Eryk-Mozdzen/rysiek/docs/Prezentacja_BITEHack.pdf

# Rysiek - autonomiczny robot promujący zdrowe żywienie

# ”KoNaR Bravo”

15.12.2024

KoNaR Bravo | RYSIEK | 15.12.2024 | 1 / 11

# Plan prezentacji

### 1 Skąd pomysł?

### 2 Dlaczego ryś?

### 3 Robotyczny bohater

### 4 Proste czyny, niebanalne osiągnięcia

5 Rozszerzenia.

### 6 Podsumowanie działań

KoNaR Bravo | RYSIEK | 15.12.2024 | 2 / 11

# Pomysł

1 Robot motywujący do zdrowego odżywiania.
2 Zastosowanie w miejscach, w których nie myślimy o tym, takich jak codzienny czas w domu, czy w pracy.
3 Przeznaczony do zastosowania indywidualnego.

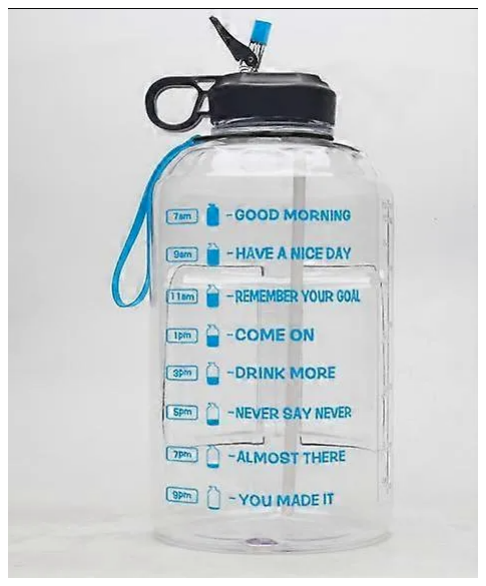
[picture p12: figure]

KoNaR Bravo | RYSIEK | 15.12.2024 | 3 / 11

# Ryś?

### Ryś - dawniej zwany ostrowidzem

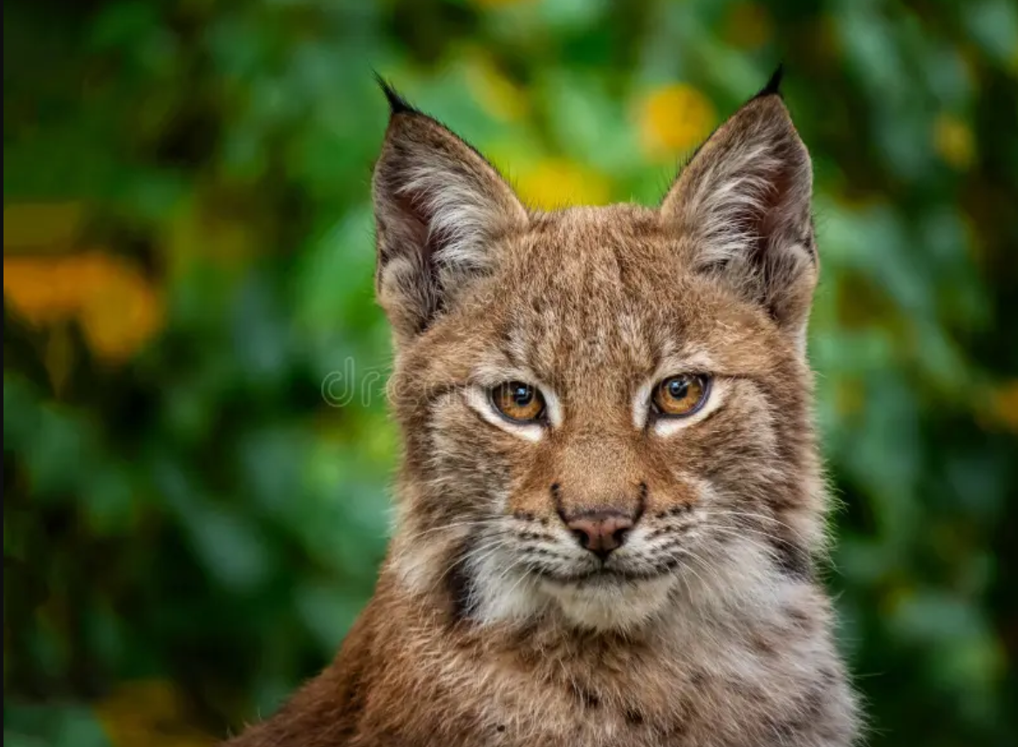
[picture p13: figure]

KoNaR Bravo | RYSIEK | 15.12.2024 | 4 / 11

# Dolina niesamowitości

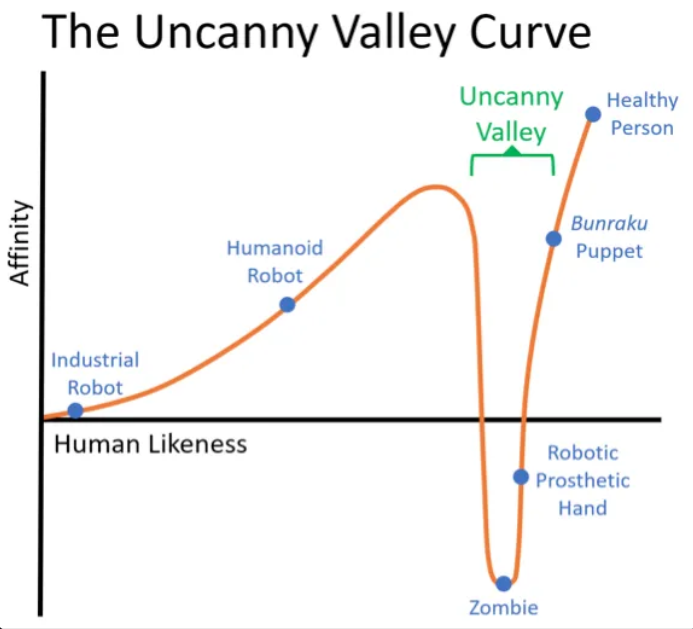
[picture p14: figure]

KoNaR Bravo | RYSIEK | 15.12.2024 | 5 / 11

# Robotyczny bohater – cel

Rysiek - autonomiczny robot promujący zdrowe żywienie, podąrzający za użytkownikiem oraz zachęcający do zdrowej przekąski. Ty stajesz się boheterem dbając o swoje zdrowie dzięki codziennym przypomnieniom Ryśka.

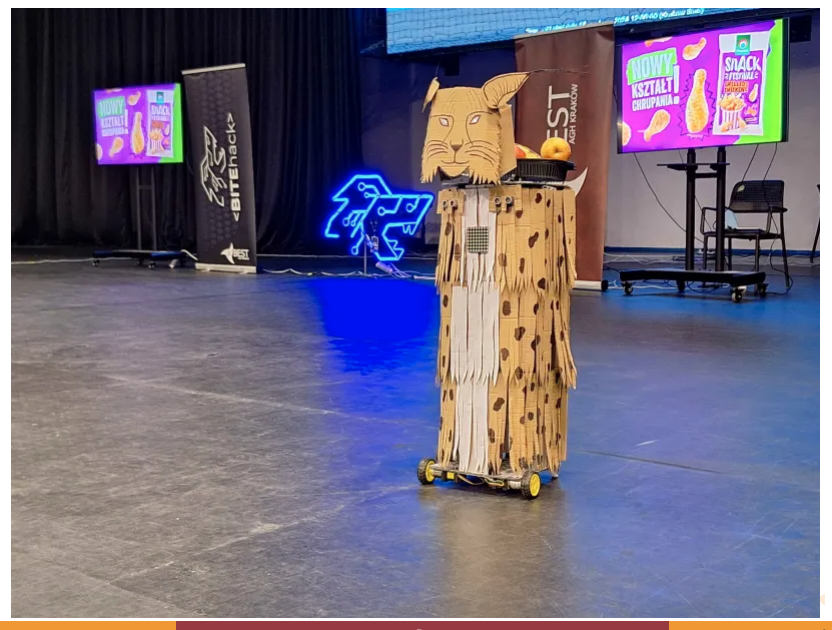
[picture p15: figure]

KoNaR Bravo | RYSIEK | 15.12.2024 | 6 / 11

# Działanie

1 Wykrywanie i podąrzanie do ludzi.
2 Oferowanie zdrowej przekąski.
3 Interakcja z użytkownikiem.

Filmy przedstawiające działanie: https://drive.google.com/drive/folders/1Dbcmw3CAuqsNJa-pyervYDqS7akAp-NI?usp=sharing (https://drive.google.com/drive/folders/1Dbcmw3CAuqsNJa-pyervYDqS7akAp-NI?usp=sharing)

KoNaR Bravo | RYSIEK | 15.12.2024 | 7 / 11

# Wykorzystane technologie

1 ESP32 – akwizycja obrazu wykorzystując kamerę RGB.
2 Raspberry Pi 3 B– analiza obrazu na bazie OpenCV.
3 Nucleo L476– sterowanie aktuatorami robota (napędy, lampy), odczyt pozostałych czujników (belka tensometryczna, dalmierze ultradźwiękowe).
4 Akumulator Litowo Polimerowy – zasilanie.

### 5 OpenCV – środowisko w języku Python służące do analizy

obrazu.

KoNaR Bravo | RYSIEK | 15.12.2024 | 8 / 11

# Rozszerzenia

1 Ulepszenie algorytmu wykrywania oraz podąrzania za ludźmi. 2 Wprowadzenie lepszego układu trakcyjnego.
3 Zastosowanie przesyłania obrazu przez interfejs przewodowy. 4 Wykorzystanie lepszej formy obudowy (sztucznego futra).

### 5 Rozbudowa struktury o zautomatyzowany podajnik

umożliwiający ustawienie personalnej diety na cały tydzień.

### 6 Dodanie rozdawania naklejek w stylu dzielny pacjent, przy

wzięciu przekąski.

KoNaR Bravo | RYSIEK | 15.12.2024 | 9 / 11

# Podsumowanie

### 1 Projekt wypełnia niezapełnioną niszę na rynku robotów

asystujących, do zastosowań indywidualnych, nie masowych, takich jak w sklepach.
2 Konstrukcja wyczerpuje możliwości niektórych elementów.

### 3 Możliwości robota społecznego są ograniczone tylko przez

percepcję użytkownika.

### 4 Udało nam się spełnić wszystkie przedstawione założenia

robota.

### 5 Wzrost zainteresowania robotami społecznymi połączony z

spadkiem kontaktów interpersonalnych pozwala zakład sukces po wprowadzeniu na rynek.

KoNaR Bravo | RYSIEK | 15.12.2024 | 10 / 11

# Zakończenie

## Rysiek poprzez codzienne czynności pozwala wydobyć bohetera z każdego z Nas!

KoNaR Bravo | RYSIEK | 15.12.2024 | 11 / 11
