Eryk-Mozdzen/rysiek/docs/kokos-2025/umocowanie/Oświadczenie do umocowania - przykład.pdf

Miasto, data

Pełnomocnictwo

My, niżej podpisani członkowie zespołu projektowego |

nazwa zespołu projektowego
niniejszym udzielamy | pełnomocnictwa do

imię i nazwisko lidera zespołu
reprezentowania nas w sprawach dotyczących projektu |

nazwa konstrukcji
w Konkursie Konstrukcji Studenckich „KOKOS”, w tym do składania i odbioru oświadczeń,

podpisywania dokumentów i prowadzenia korespondencji w naszym imieniu.

Data, podpis osoby umocowanej

podpisy osób udzielających pełnomocnictwa
