Eryk-Mozdzen/rysiek/docs/kokos-2025/dokumentacja-techniczna/figures/base.jpg

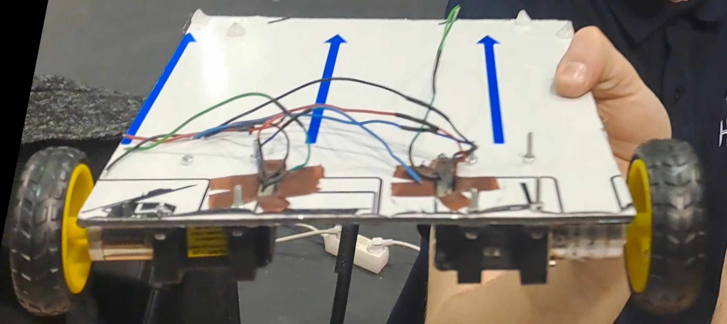
docs/kokos-2025/dokumentacja-techniczna/figures/base.jpg
