Eryk-Mozdzen/rysiek/docs/kokos-2025/dokumentacja-techniczna/figures/frame.jpg

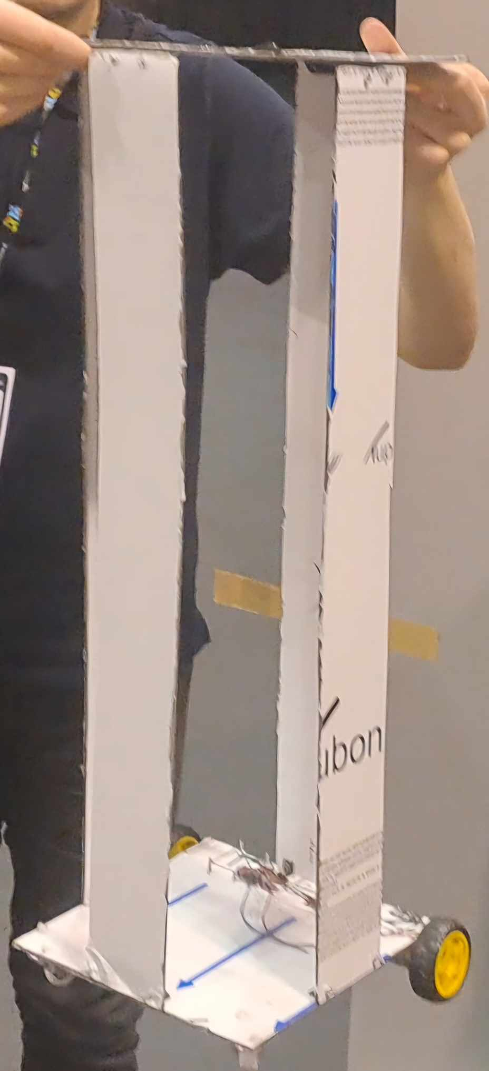
docs/kokos-2025/dokumentacja-techniczna/figures/frame.jpg
