Eryk-Mozdzen/rysiek/docs/kokos-2025/dokumentacja-techniczna/figures/full.jpg

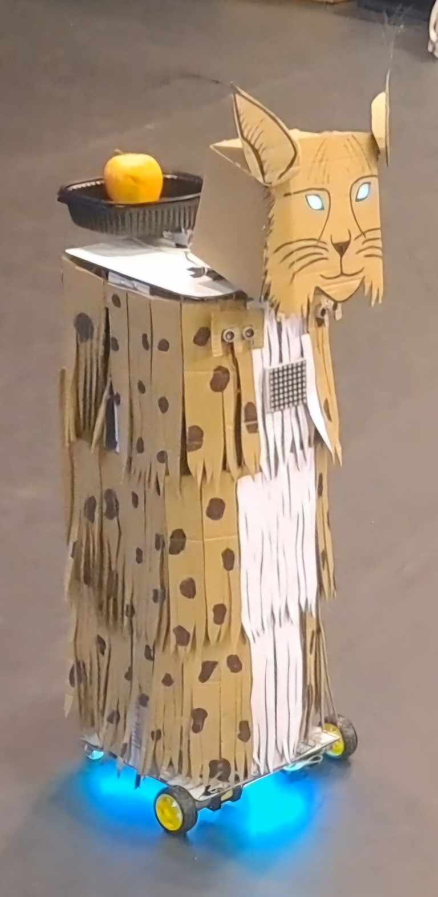
docs/kokos-2025/dokumentacja-techniczna/figures/full.jpg
