Eryk-Mozdzen/rysiek/docs/nucleo2.png

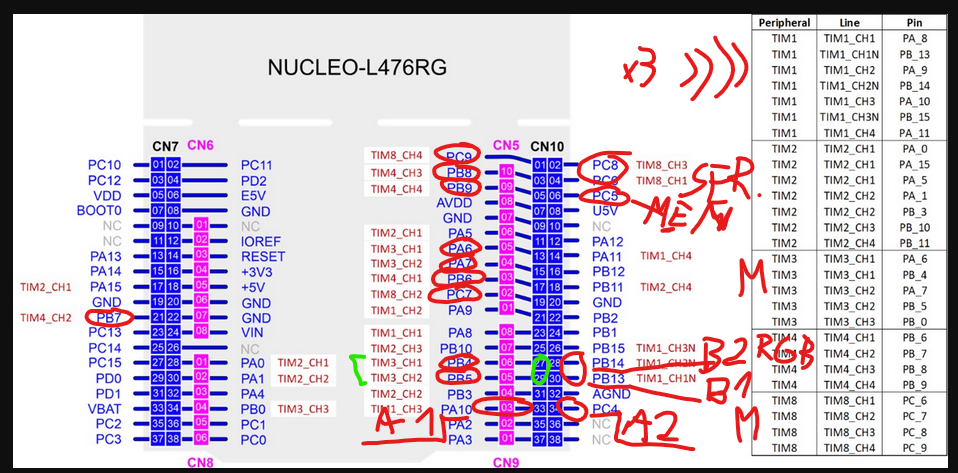
docs/nucleo2.png
