Eryk-Mozdzen/rysiek/docs/nucleo4.png

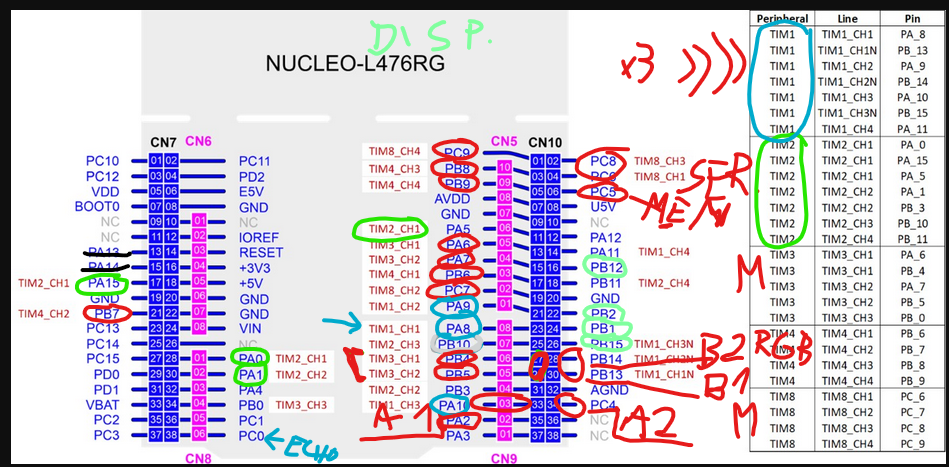
docs/nucleo4.png
