Eryk-Mozdzen/rysiek/docs/nucleo8.png

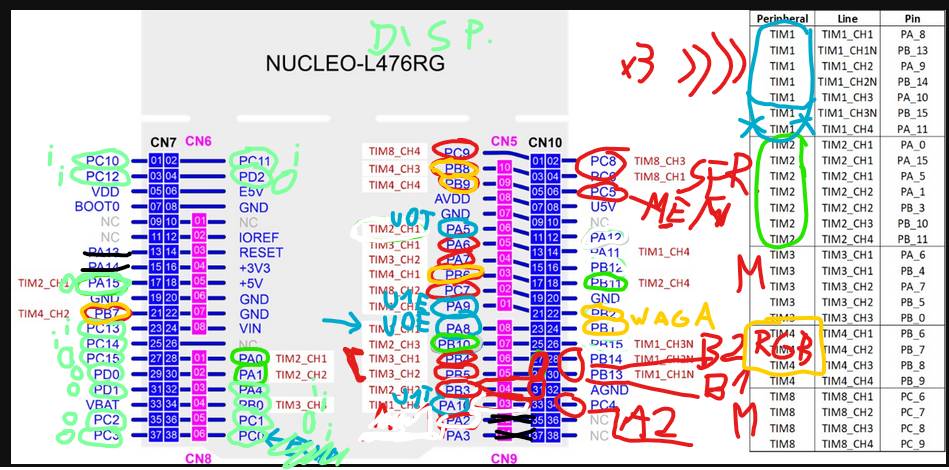
docs/nucleo8.png
