Eryk-Mozdzen/rysiek/docs/nucleo.png

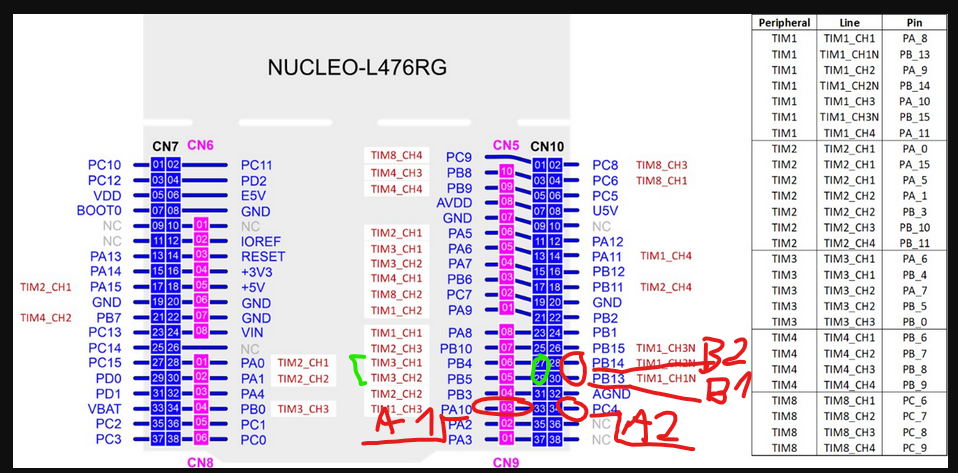
docs/nucleo.png
