Eryk-Mozdzen/rysiek/nucleo/hackatonL476/hackatonL476.ioc

Mcu.UserName=STM32L476RGTx
PA0.GPIO_Label=SERVO1
PA0.Signal=S_TIM2_CH1
PA1.GPIO_Label=SERVO2
PA1.Signal=S_TIM2_CH2
PA10.GPIO_Label=U1_TRIG
PA10.Signal=S_TIM1_CH3
PA12.GPIO_Label=SW
PA12.Signal=GPIO_Input
PA2.Signal=USART2_TX
PA3.Signal=USART2_RX
PA4.GPIO_Label=MATRIX_COL7
PA4.Signal=GPIO_Output
PA5.GPIO_Label=U0_ECHO
PA5.Signal=GPXTI5
PA6.GPIO_Label=M2_B2
PA6.Signal=GPIO_Output
PA7.GPIO_Label=M2_B1
PA7.Signal=GPIO_Output
PA8.GPIO_Label=U0_TRIG
PA8.Signal=S_TIM1_CH1
PA9.GPIO_Label=U1_ECHO
PA9.Signal=GPXTI9
PB0.GPIO_Label=MATRIX_COL6
PB0.Signal=GPIO_Output
PB1.GPIO_Label=BEAM_CLK
PB1.Signal=GPIO_Output
PB10.Signal=USART3_TX
PB11.Signal=USART3_RX
PB13.GPIO_Label=M3_B1
PB13.Signal=GPIO_Output
PB14.GPIO_Label=M3_B2
PB14.Signal=GPIO_Output
PB2.GPIO_Label=BEAM_DOUT
PB2.Signal=GPIO_Input
PB5.GPIO_Label=M2_A2
PB5.Signal=GPIO_Output
PB6.GPIO_Label=STRIPE_R
PB6.Signal=S_TIM4_CH1
PB7.GPIO_Label=STRIPE_G
PB7.Signal=S_TIM4_CH2
PB8.GPIO_Label=STRIPE_B
PB8.Signal=S_TIM4_CH3
PB9.GPIO_Label=STRIPE_W
PB9.Signal=S_TIM4_CH4
PC0.GPIO_Label=MATRIX_COL5
PC0.Signal=GPIO_Output
PC1.GPIO_Label=MATRIX_ROW7
PC1.Signal=GPIO_Output
PC10.GPIO_Label=MATRIX_COL0
PC10.Signal=GPIO_Output
PC11.GPIO_Label=MATRIX_COL1
PC11.Signal=GPIO_Output
PC12.GPIO_Label=MATRIX_COL2
PC12.Signal=GPIO_Output
PC13.GPIO_Label=MATRIX_COL3
PC13.Signal=GPIO_Output
PC2.GPIO_Label=MATRIX_ROW5
PC2.Signal=GPIO_Output
PC3.GPIO_Label=MATRIX_ROW6
PC3.Signal=GPIO_Output
PC4.GPIO_Label=M3_A1
PC4.Signal=GPIO_Output
PC5.GPIO_Label=Mx_EN
PC5.Signal=GPIO_Output
PC6.GPIO_Label=M1_A1
PC6.Signal=GPIO_Output
PC7.GPIO_Label=M1_A2
PC7.Signal=GPIO_Output
PC8.GPIO_Label=M1_B1
PC8.Signal=GPIO_Output
PC9.GPIO_Label=M1_B2
PC9.Signal=GPIO_Output
PD2.GPIO_Label=MATRIX_ROW0
PD2.Signal=GPIO_Output
