Eryk-Mozdzen/rysiek/(commit log)

2024-12-14 Combined camera read and face detect with timeout error handling
2024-12-14 Working UART
2024-12-15 led strip
2024-12-15 led matrix
2024-12-20 rainbow leds
2025-03-10 add files from Jetson Orin Nano
    [0.csv, 1.csv, 2.csv, 3.csv, 4.csv, 5.csv, 6.csv, 7.csv]
